whyme12/YUDX-tool-changer/Gcode/Klipper/Readme.txt

This is still work in progress, klipper macros will be here eventually
