whyme12/YUDX-tool-changer/BOM.xlsx

Sheet: BOM
 | Info: 1. The finished YUDX extruder kit may be released in the coming months. You may wait for its launch. 2. Amazon links were found by Claude Code. Links may be incorrect, please feedback any errors to me. 3. discord:https://discord.gg/vE4ExaVR3 4. https://github.com/dumplinglab/YUDX-tool-changer
number | Part group | Part Name (corresponds to STEP file) | Qty | Type | Details | Notes
1 | VORON existing part | MGN12H_block | 1 | Standard Part | MGN12H 300mm Premium Linear Guide Rail 2 Pcs MGN12 Linear Slide 8mm for 3D Printer CNC (2 Pcs/Pack)
2 | VORON existing part | MGN12 | 1 | Standard Part | MGN12H 300mm Premium Linear Guide Rail 2 Pcs MGN12 Linear Slide 8mm for 3D Printer CNC (2 Pcs/Pack)
3 | VORON existing part | Aluminum profiles | 1 | Standard Part
4 | Printer specific part | voron_connecting_part | 1 | 3D Printed Part |  | Add mounting option for EBB36?
5 | Printer specific part | M3x8mm ISO4762 | 4 | Standard Part | Screws to mount to MGN12 block
6 | Extruder | outer_shell_of_extruder | 1 | 3D Printed Part
7 | Extruder | double_layer_gear | 2 | Custom Gear
8 | Extruder | extrude_gear | 2 | Custom Gear
9 | Extruder | extrude_wheel | 2 | HGX-Lite | All included in a single HGX-Lite gear kit
10 | Extruder | needle_bearing | 2 | HGX-Lite | All included in a single HGX-Lite gear kit
11 | Extruder | one_way_bearing | 2 | Standard Part | HF0306
12 | Extruder | gear_container_metal_part | 2 | CNC
13 | Extruder | axle_for_extrude_gear | 2 | Custom part? | Diameter: 3mm, length: 24mm, 8mm ground flat on one side (1/4 D-Shaft) | change to D-shaft?
14 | Extruder | 0.5m10gear | 2 | Standard Part? | M0.5, 10 teeth, 3mm D-shaft | change to 12 teeth for more strength?
15 | Extruder | gear_container_plastic_part | 2 | 3D Printed Part
16 | Extruder | gear_container_metal_part_mirror | 2 | CNC
17 | Extruder | 4mm_flange_bearing | 6 | Standard Part | MF74ZZ flange bearing 4mmx7mmx2.5mm
18 | Extruder | 3mm_flange_bearing | 4 | Standard Part | MF63ZZ flange bearing 3mmx6mmx2.5mm
19 | Extruder | 4mm_axle | 2 | Standard Part | length 32mm
20 | Extruder | line_cut_rack | 1 | Custom Wire-cut Part | M0.5 gears require wire cutting
21 | Extruder | rack_below_part | 1 | CNC
22 | Extruder | extruder_bottom_metal_part | 1 | CNC
23 | Extruder | 36_stepper_motor | 1 | Standard part? | possibly fitting motor: Flashforge AD5X extruder motor
24 | Extruder | cylinder_pin1.5_5 | 6 | Standard Part | Diameter: 1.5mm, Length: 4mm
25 | Extruder | 4mm_flange_bearing_8mm | 2 | Standard Part | MF84ZZ flange bearing 4mmx8mmx3mm
26 | Extruder | extruder_top_metal_part_mirror | 1 | CNC
27 | Extruder | extruder_top_metal_part | 1 | CNC
28 | Extruder | throat_cooling_fan_seat | 1 | 3D Printed Part
29 | Extruder | 2510fan | 1 | Standard Part
30 | Extruder | model_cooling_fan_seat | 1 | 3D Printed Part
31 | Extruder | spring_0.8x7x30mm | 1 | Standard Part
32 | Extruder | 5020fan | 1 | Standard Part
33 | Extruder | bed_switch | 1 | Standard Part | for example: Omron D2F-01
34 | Extruder | M2x8mm ISO4762 | 2 | Standard Part | M2x8mm ISO4762
35 | Extruder | M3x10mm ISO7380-1 | 4 | Standard Part | Screws to mount model_cooling_fan_seat
36 | Extruder | front_cover | 1 | 3D Printed Part
37 | Extruder | M3x8mm ISO7380-1 | 2 | Standard Part | Screws to mount front_cover
38 | Extruder | back_cover | 1 | 3D Printed Part
39 | Extruder | M3x30mm ISO7380-1 | 8 | Standard Part | Screws to mount extruder_top_metal_part to extruder_bottom_metal_part
40 | Extruder | M3x8mm ISO10642 | 2 | Standard Part | Screws to mount stepper motor
41 | Extruder | M3x10mm ISO4762 | 4 | Standard Part | Screws to mount extruder_bottom_metal_part to voron_connecting_part
42 | Extruder | M3x8mm ISO10642 | 4 | Standard Part | Screws to mount gear_container_metal_part
43 | Extruder | M3x5mm ISO7380-1 | 2 | Standard Part | Screws to mount gear_container_plastic_part to gear_container_metal_part
44 | Extruder | M3x12mm ISO7380-1 | 2 | Standard Part | Screws for Spring
45 | Extruder | M3x14mm ISO7380-1 | 4 | Standard Part | Screws to mount 2510fan | Walls could be too thin around heat inserts, needs to be tested
46 | Extruder | M3x12mm ISO7380-1 | 3 | Standard Part | Screws to mount throat_cooling_fan_seat
47 | Extruder | A1104_hall_effect_sensor | 1 | Standard Part | (optional) Hall effect sensor A1104LUA-T (not SMD variant) to detect tool change fails
48 | Extruder & Toolhead | magnet_5-15-3 | 4 + N*4 | Standard Part |  | Pocket size in Step maybe to small? Only 14.5x4.5mm
49 | Toolhead | Tool_head_front_part | N | 3D Printed Part |  | Pocket size in Step maybe to small? Only 14.5x4.5mm
50 | Toolhead | Bambu_Hotend | N | Standard Part |  | Create second Tool_head_front_part to support Snapmaker U1 hotends
51 | Toolhead | 4mm_ball | N*4 | Standard Part | 4mm ball bearing ball
52 | Toolhead | Tool_head_back_part | N | 3D Printed Part |  | Do the latches work when 3d printed and not break off?
53 | Toolhead | square_nut | N*2 | Standard Part
54 | Toolhead | M3x14mm ISO4762 | N*2 | Standard Part | Screws to mount Bambu_Hotend
55 | Toolhead | M3x6mm ISO7380-1 | N*4 | Standard Part | Screws to mount Tool_head_back_part to Tool_head_front_part
56 | Toolhead | Magnet_4x2mm | N | Standard Part | Diameter 4mm, height 2mm | To be able to detect toolchange success using hall effect sensor
57 | Dock | tool_head_seat | N | 3D Printed Part |  | Maybe add additional screws from front?
58 | Dock | mini_door_lock_switch | N*2 | Standard Part
59 | Dock | nozzle_cleaning_part | N | 3D Printed Part
60 | Dock | 3010fan | N | Standard Part
61 | Dock | air_guide | N | 3D Printed Part
62 | Dock | 4.5mm_silicon_sleeve | N | ??? |  | where to get this part from?
63 | Dock | M3x12mm ISO4762 | N*4 | Standard Part | Screws to mount nozzle_cleaning_part
64 | Dock | M3x20mm ISO4762 | N*4 | Standard Part | Screws to mount 3010fan and air_guide
65 | Dock | M3x8mm ISO4762 | N*2 | Standard Part | Screws to mount tool_head_seat to aluminium extrusion
66 | Dock | T-nut | N*2 | Standard Part | T-nut to mount tool_head_seat to aluminium extrusion
67 | Overall | Heat set inserts | 31+N*8 | Standard Part | Heat set inserts M3x5x4mm (Voron style)

Sheet: Screw types
Type | Quantity
M3x8mm ISO4762 | 4+N*2
M3x10mm ISO4762 | 4
M3x12mm ISO4762 | N*4
M3x14mm ISO4762 | N*2
M3x20mm ISO4762 | N*4
M3x8mm ISO10642 | 6
M3x5mm ISO7380-1 | 2
M3x6mm ISO7380-1 | N*4
M3x8mm ISO7380-1 | 2
M3x10mm ISO7380-1 | 4
M3x12mm ISO7380-1 | 5
M3x14mm ISO7380-1 | 4
M3x30mm ISO7380-1 | 8
