whyme12/YUDX-tool-changer/CAD/YUDX assemble.STEP

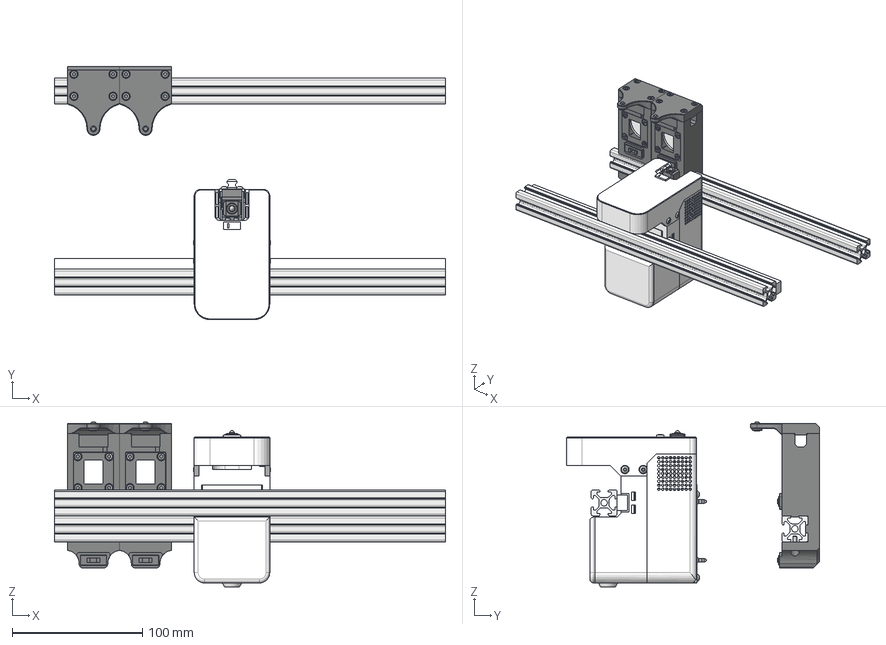
[picture p1: CAD file, 2026-09-14]
CAD/YUDX assemble.STEP
300.0 x 194.4 x 126.4 mm
M3_heat_insert x 47
throat_cooling_fan_seat
2510fan
model_cooling_fan_seat
5020fan
bed_switch
back_cover
tool_head_seat x 2
mini_door_lock_switch x 4
nozzle_cleaning_part x 2
3010fan x 2
air_guide x 2
4.5mm_silicon_sleeve x 2
ISO 4762 - M3 x 12 Steel 8.8 Plain x 8
ISO 4762 - M3 x 8 Steel 4.6 Plain x 4
ISO 4762 - M3 x 20 Steel 8.8 Plain x 8
ISO 7380-1 - M3 x 10 Steel 4.6 Plain x 4
outer_shell_of_extruder
double_layer_gear
extrude_gear
extrude_wheel
needle_bearing
one_way_bearing
gear_container_metal_part
axle_for_extrude_gear
0.5m10gear
gear_container_plastic_part
gear_container_metal_part_mirror
4mm_flange_bearing x 4
3mm_flange_bearing x 2
4mm_axle
line_cut_rack
rack_below_part
extruder_bottom_metal_part
36_stepper_motor
4mm_flange_bearing_8mm x 2
cylinder_pin1.5_5 x 6
magnet_5-15-3 x 4
镜向double_layer_gear
镜向extrude_gear
镜向extrude_wheel
镜向needle_bearing
镜向one_way_bearing
镜向gear_container_metal_part
镜向axle_for_extrude_gear
镜向0.5m10gear
镜向gear_container_plastic_part
镜向gear_container_metal_part_mirror
镜向4mm_flange_bearing x 2
镜向3mm_flange_bearing x 2
镜向4mm_axle
ISO 7380-1 - M3 x 30 Steel 8.8 Black x 8
DIN EN ISO 10642 - M3 x 8 Steel 8.8 Plain x 2
DIN 7991 - M3x8 Steel 10.9 Plain x 4
ISO 7380-2 - M3 x 12 Steel 4.6 Plain x 2
ISO 7380-1 - M3 x 6 Steel 4.6 Plain x 6
A1104_hall_effect_sensor
spring_0.8x7x30mm
Tool_head_front_part
Bambu_Hotend1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
