whyme12/YUDX-tool-changer/CAD/YUDX Extruder.STEP

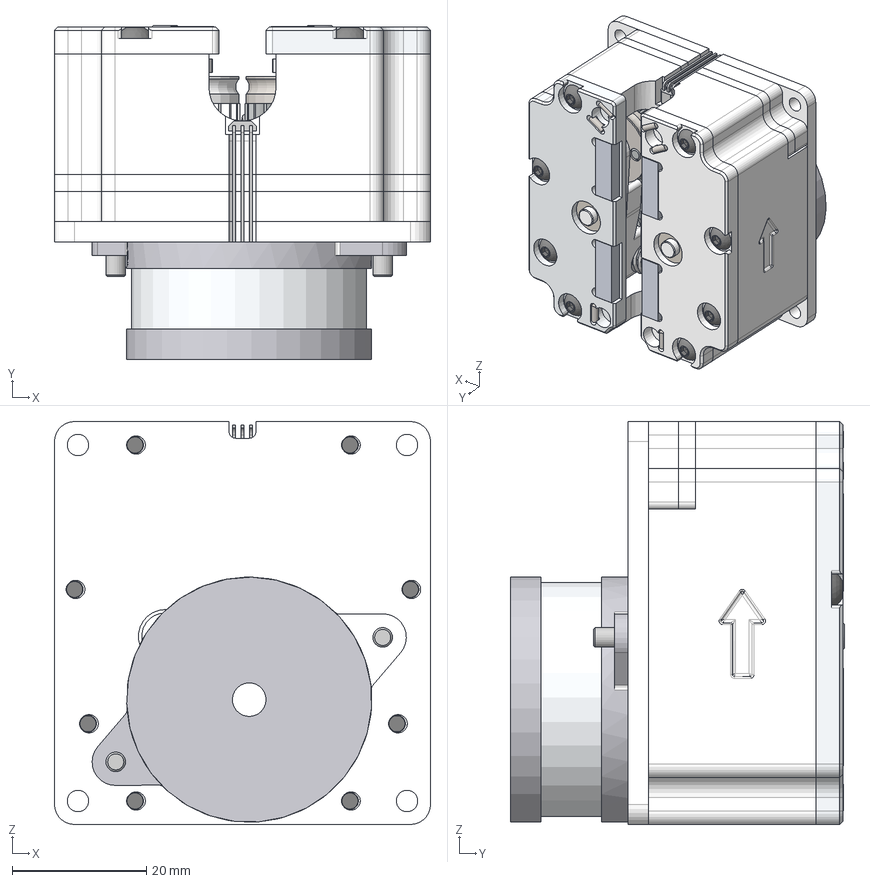
[picture p2: CAD file, 2026-09-14]
CAD/YUDX Extruder.STEP
56.0 x 49.7 x 60.0 mm
outer_shell_of_extruder
double_layer_gear
extrude_gear
extrude_wheel
needle_bearing
one_way_bearing
gear_container_metal_part
axle_for_extrude_gear
0.5m10gear
gear_container_plastic_part
gear_container_metal_part_mirror
4mm_flange_bearing x 4
3mm_flange_bearing x 2
4mm_axle
M3_heat_insert x 6
line_cut_rack
rack_below_part
extruder_bottom_metal_part
36_stepper_motor
4mm_flange_bearing_8mm x 2
cylinder_pin1.5_5 x 6
magnet_5-15-3 x 4
镜向double_layer_gear
镜向extrude_gear
镜向extrude_wheel
镜向needle_bearing
镜向one_way_bearing
镜向gear_container_metal_part
镜向axle_for_extrude_gear
镜向0.5m10gear
镜向gear_container_plastic_part
镜向gear_container_metal_part_mirror
镜向4mm_flange_bearing x 2
镜向3mm_flange_bearing x 2
镜向4mm_axle
ISO 7380-1 - M3 x 30 Steel 8.8 Black x 8
DIN EN ISO 10642 - M3 x 8 Steel 8.8 Plain x 2
DIN 7991 - M3x8 Steel 10.9 Plain x 4
ISO 7380-2 - M3 x 12 Steel 4.6 Plain x 2
ISO 7380-1 - M3 x 6 Steel 4.6 Plain x 2
A1104_hall_effect_sensor
spring_0.8x7x30mm
