whyme12/YUDX-tool-changer/CNC Parts/2x_gear_container_metal_part.step

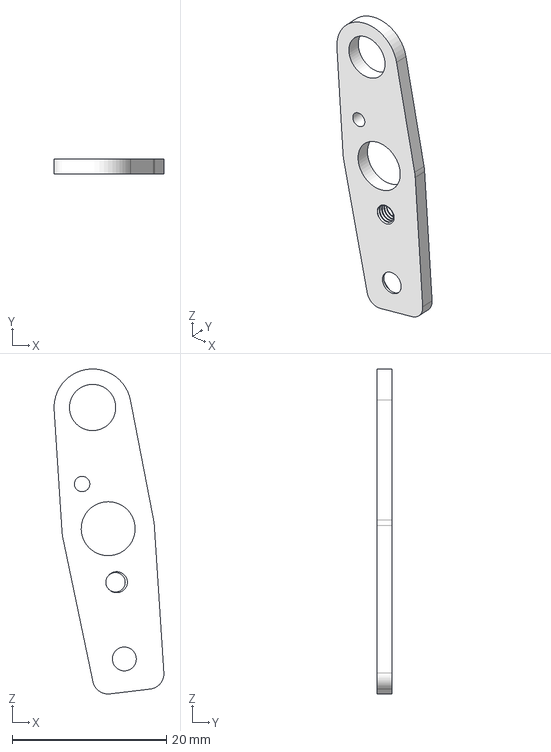
[picture p3: CAD file, 2026-09-12]
CNC Parts/2x_gear_container_metal_part.step
14.2 x 2.00 x 42.2 mm
