whyme12/YUDX-tool-changer/STLs/Dock/nozzle_cleaning_part.stl

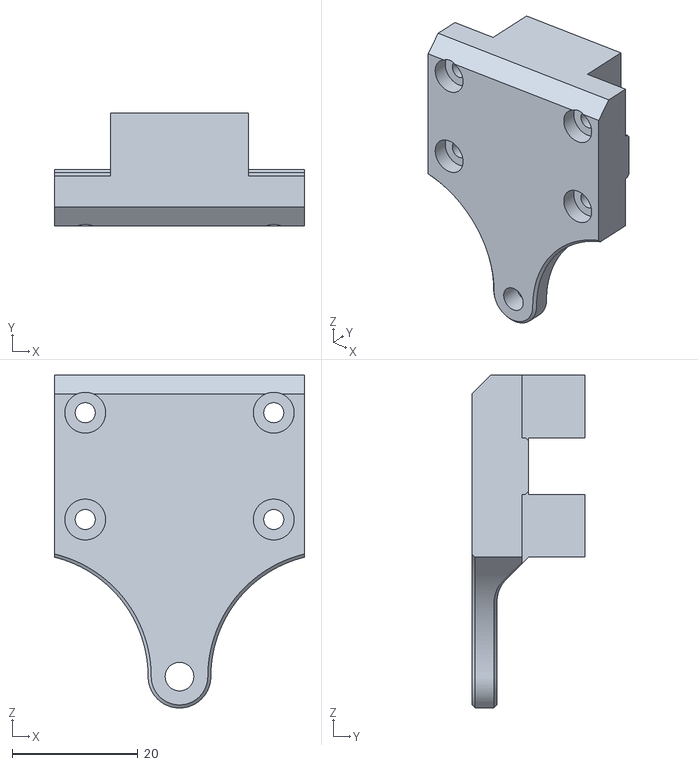
[picture p4: CAD file, 2026-09-12]
STLs/Dock/nozzle_cleaning_part.stl
39.8 x 18.0 x 53.0
