whyme12/YUDX-tool-changer/STLs/Extruder/gear_container_plastic_part.stl

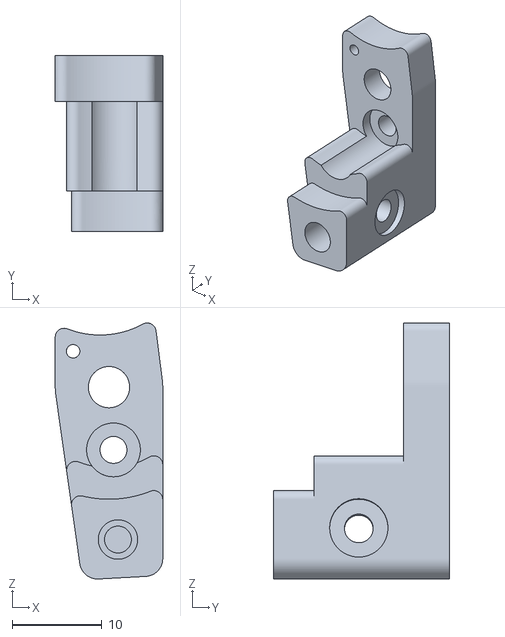
[picture p5: CAD file, 2026-09-12]
STLs/Extruder/gear_container_plastic_part.stl
12.0 x 19.6 x 28.6
