whyme12/YUDX-tool-changer/STLs/Printer specific/Voron2.4 MGN12/throat_cooling_fan_seat.stl

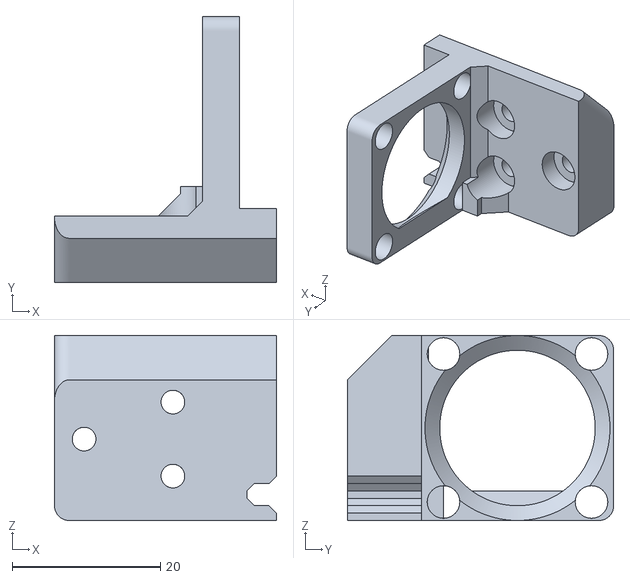
[picture p6: CAD file, 2026-09-12]
STLs/Printer specific/Voron2.4 MGN12/throat_cooling_fan_seat.stl
30.0 x 36.0 x 25.0
