whyme12/YUDX-tool-changer/STLs/Toolhead/Tool_head_front_part.stl

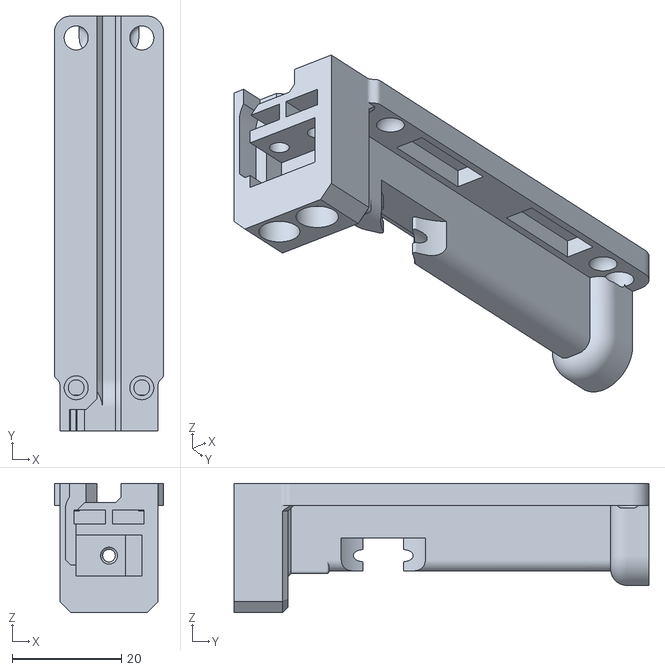
[picture p7: CAD file, 2026-09-14]
STLs/Toolhead/Tool_head_front_part.stl
20.0 x 75.9 x 23.6
