whyme12/YUDX-tool-changer/CNC Parts/line_cut_rack.step

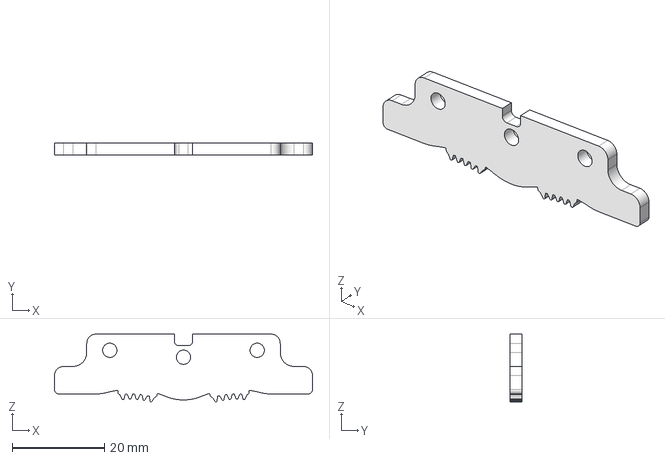
[picture p8: CAD file, 2026-09-12]
CNC Parts/line_cut_rack.step
56.0 x 2.50 x 14.7 mm
