whyme12/YUDX-tool-changer/STLs/Dock/air_guide.stl

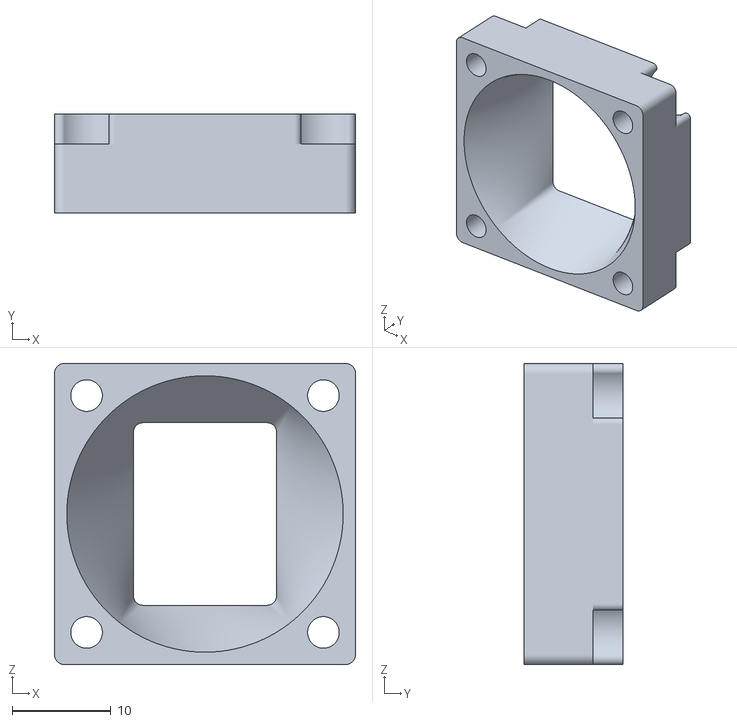
[picture p9: CAD file, 2026-09-12]
STLs/Dock/air_guide.stl
30.5 x 10.0 x 30.5
