whyme12/YUDX-tool-changer/STLs/Printer specific/Voron2.4 MGN12/voron_connecting_part.stl

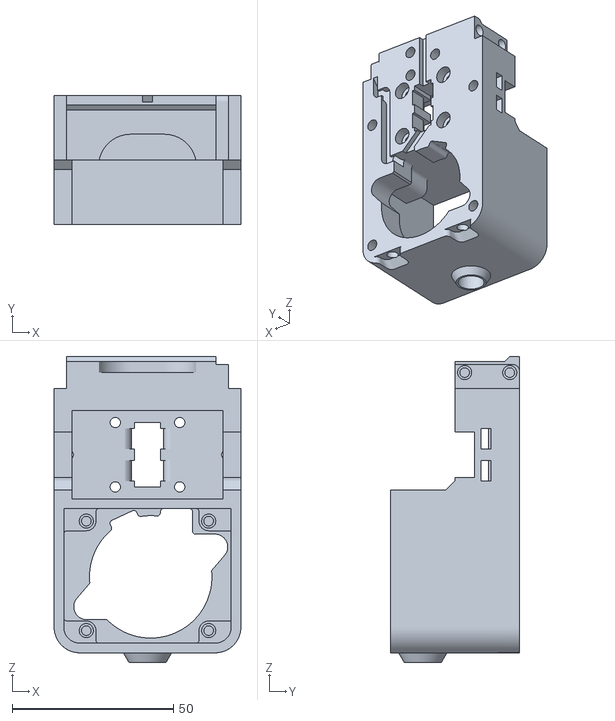
[picture p10: CAD file, 2026-09-12]
STLs/Printer specific/Voron2.4 MGN12/voron_connecting_part.stl
58.0 x 40.0 x 95.0
