whyme12/YUDX-tool-changer/STLs/Toolhead/Tool_head_back_part.stl

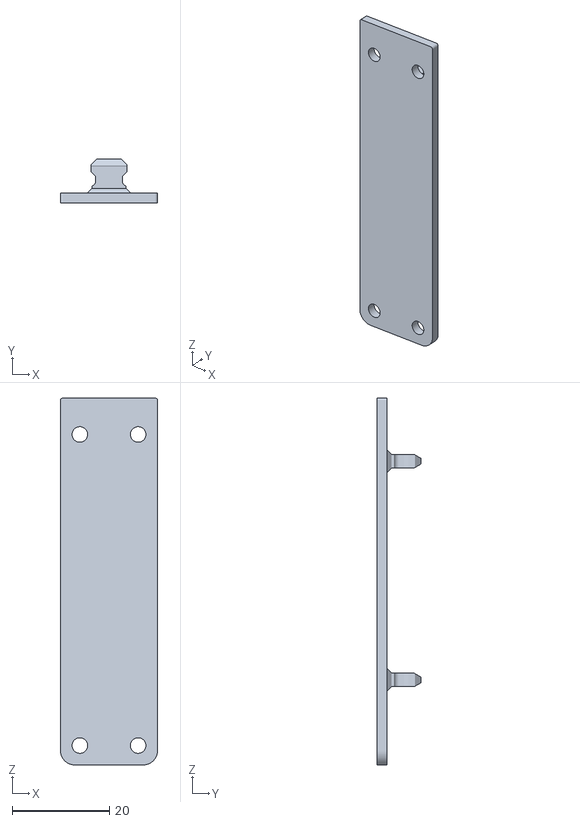
[picture p11: CAD file, 2026-09-12]
STLs/Toolhead/Tool_head_back_part.stl
20.0 x 9.00 x 75.5
