whyme12/YUDX-tool-changer/CNC Parts/extruder_top_metal_part_mirror.step

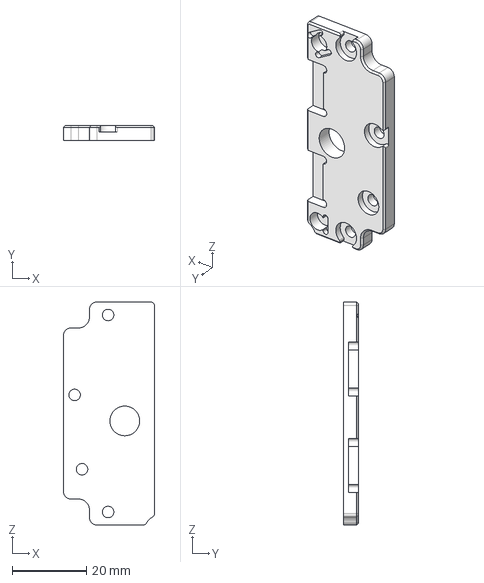
[picture p13: CAD file, 2026-09-12]
CNC Parts/extruder_top_metal_part_mirror.step
24.5 x 4.00 x 60.0 mm
