whyme12/YUDX-tool-changer/STLs/Dock/tool_head_seat.stl

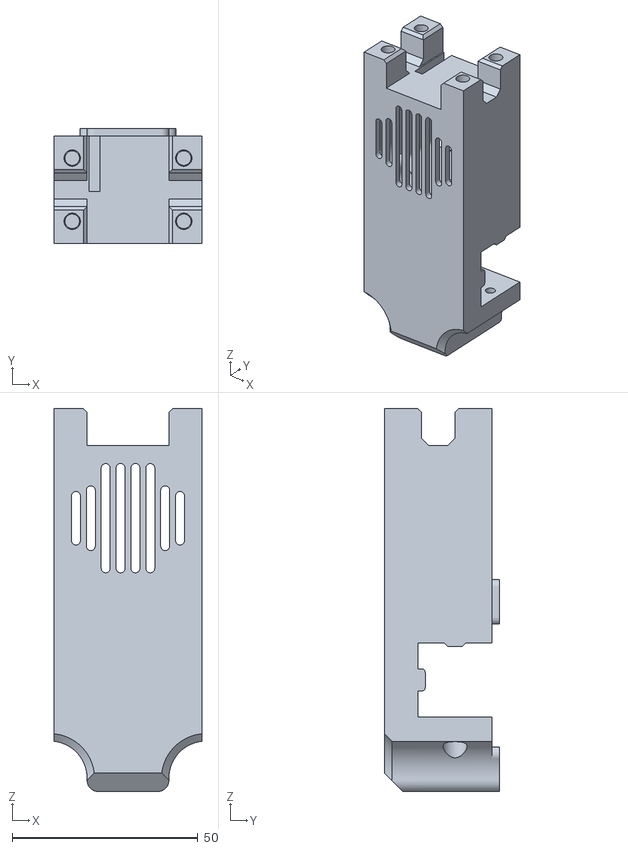
[picture p14: CAD file, 2026-09-12]
STLs/Dock/tool_head_seat.stl
39.8 x 31.0 x 103.0
