whyme12/YUDX-tool-changer/STLs/Extruder/outer_shell_of_extruder.stl

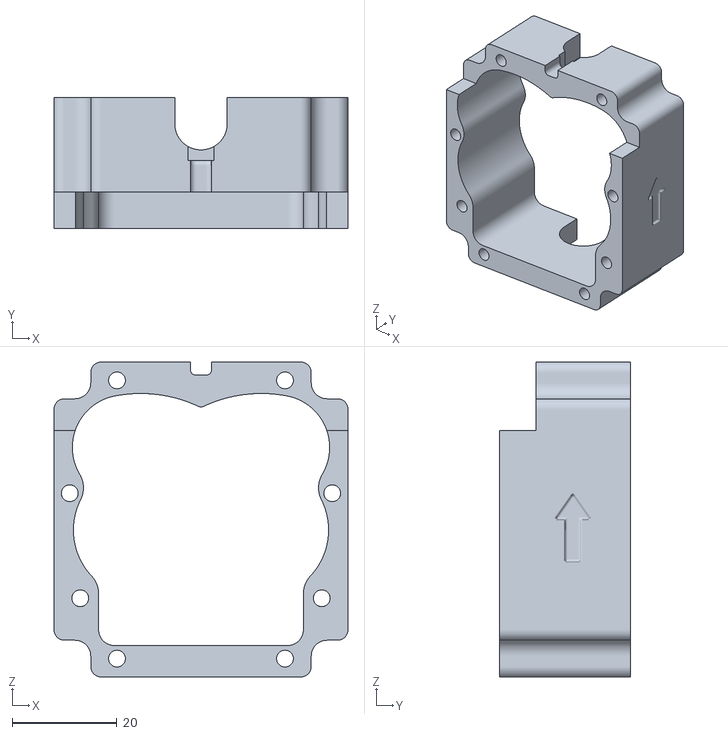
[picture p15: CAD file, 2026-09-12]
STLs/Extruder/outer_shell_of_extruder.stl
56.0 x 25.0 x 60.0
