whyme12/YUDX-tool-changer/STLs/Printer specific/Voron2.4 MGN12/back_cover.stl

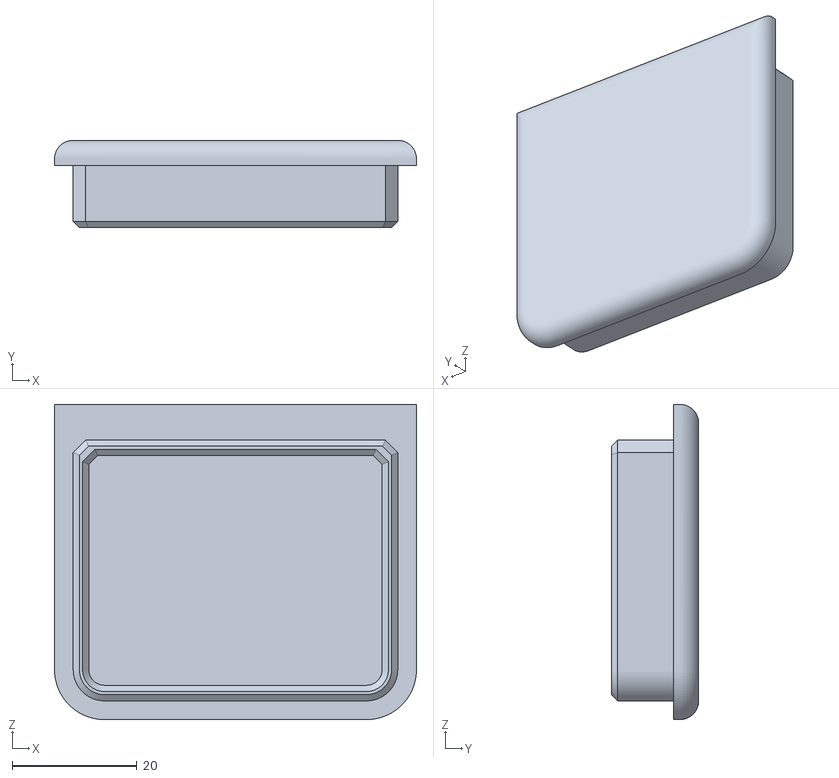
[picture p16: CAD file, 2026-09-12]
STLs/Printer specific/Voron2.4 MGN12/back_cover.stl
58.0 x 14.0 x 50.5
