whyme12/YUDX-tool-changer/CAD/YUDX_toolhead_seat.step

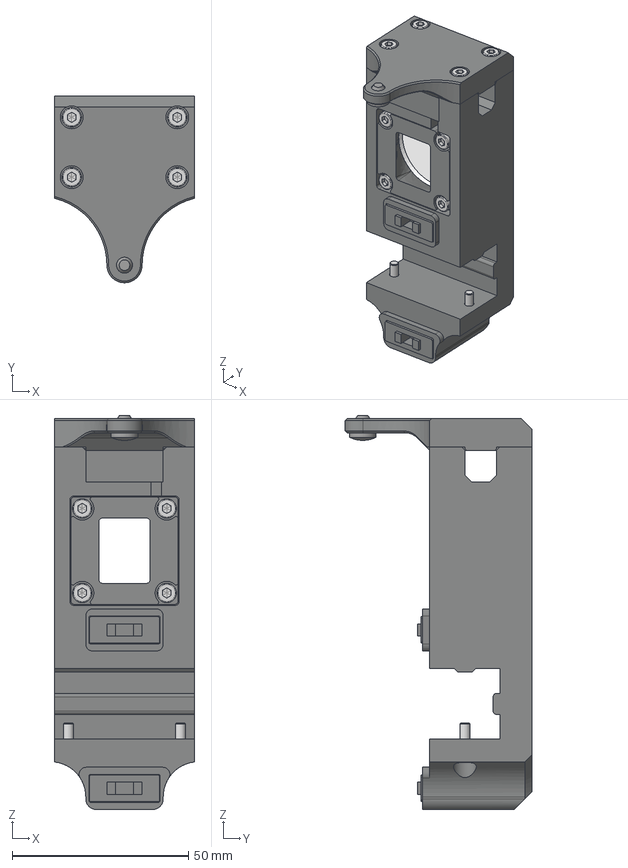
[picture p17: CAD file, 2026-09-12]
CAD/YUDX_toolhead_seat.step
39.8 x 53.0 x 111.9 mm
tool_head_seat
mini_door_lock_switch x 2
nozzle_cleaning_part
3010fan
air_guide
4.5mm_silicon_sleeve
M3_heat_insert x 8
ISO 4762 - M3 x 12 Steel 8.8 Plain x 4
ISO 4762 - M3 x 8 Steel 4.6 Plain x 2
ISO 4762 - M3 x 20 Steel 8.8 Plain x 4
