whyme12/YUDX-tool-changer/STLs/Printer specific/Voron2.4 MGN12/front_cover.stl

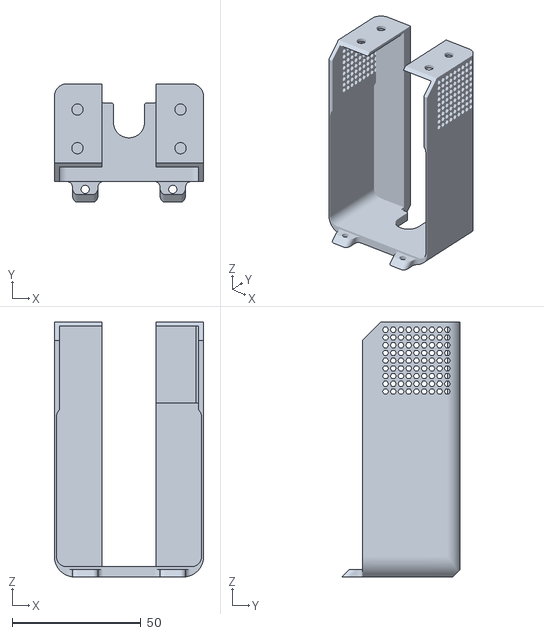
[picture p18: CAD file, 2026-09-12]
STLs/Printer specific/Voron2.4 MGN12/front_cover.stl
58.0 x 46.0 x 99.0
