whyme12/YUDX-tool-changer/CNC Parts/2x_double_layer_gear.step

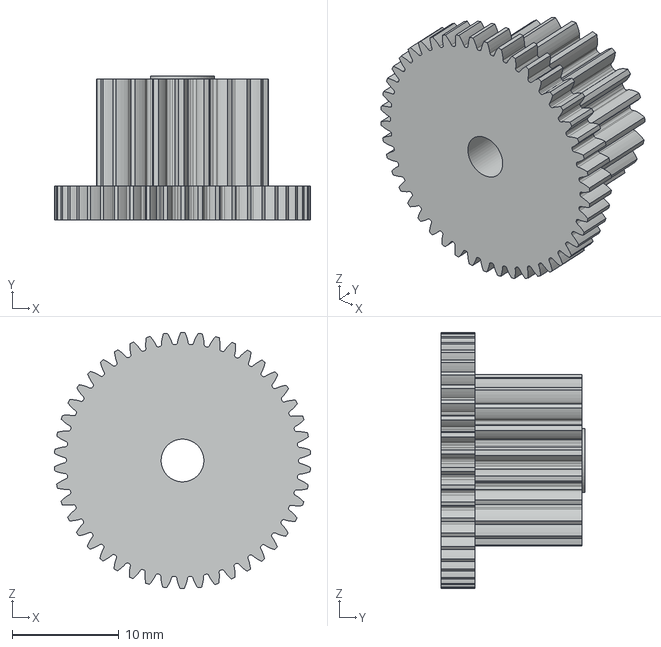
[picture p19: CAD file, 2026-09-12]
CNC Parts/2x_double_layer_gear.step
24.0 x 13.5 x 24.0 mm
