whyme12/YUDX-tool-changer/STLs/Printer specific/Voron2.4 MGN12/model_cooling_fan_seat.stl

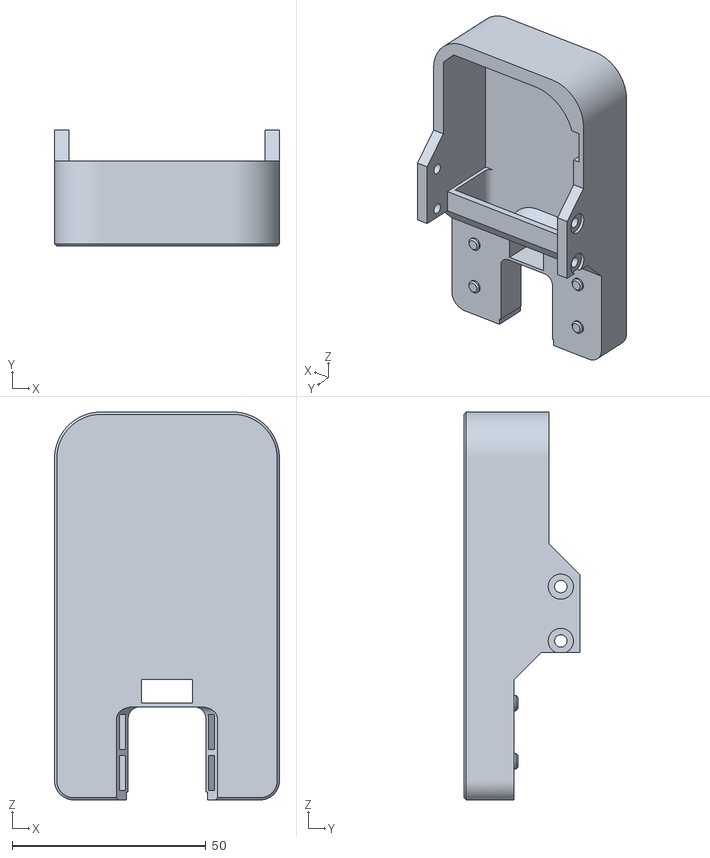
[picture p20: CAD file, 2026-09-12]
STLs/Printer specific/Voron2.4 MGN12/model_cooling_fan_seat.stl
58.0 x 30.0 x 100.0
