whyme12/YUDX-tool-changer/CNC Parts/extruder_bottom_metal_part.step

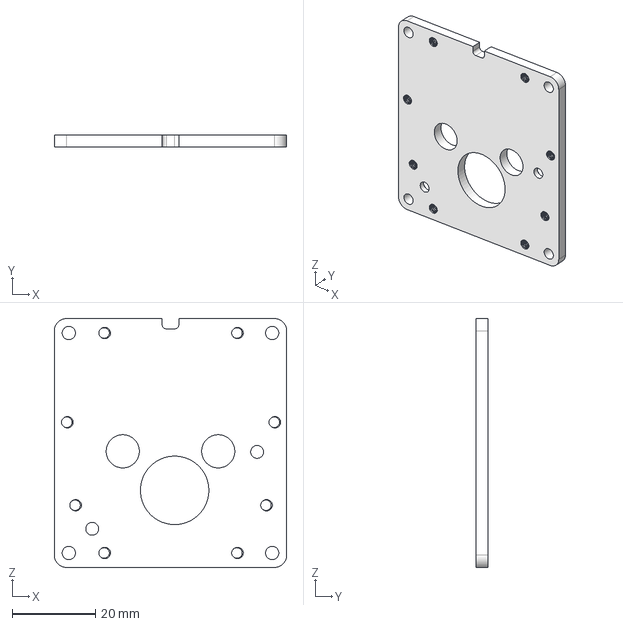
[picture p21: CAD file, 2026-09-12]
CNC Parts/extruder_bottom_metal_part.step
56.0 x 3.00 x 60.0 mm
