whyme12/YUDX-tool-changer/CNC Parts/rack_below_part.step

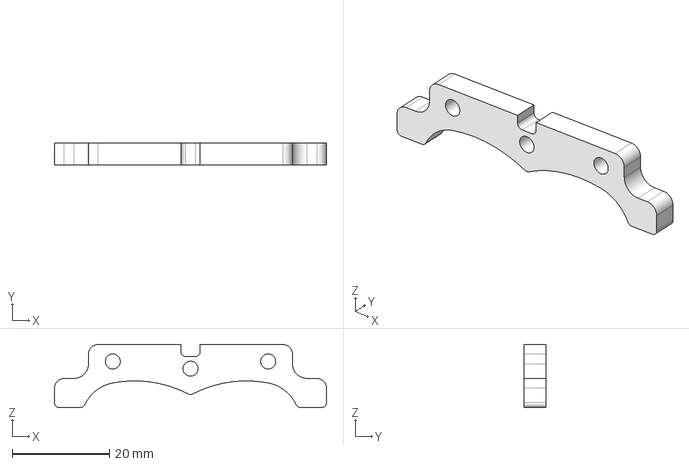
[picture p22: CAD file, 2026-09-12]
CNC Parts/rack_below_part.step
56.0 x 4.50 x 13.0 mm
