whyme12/YUDX-tool-changer/CNC Parts/2x_extrude_gear.step

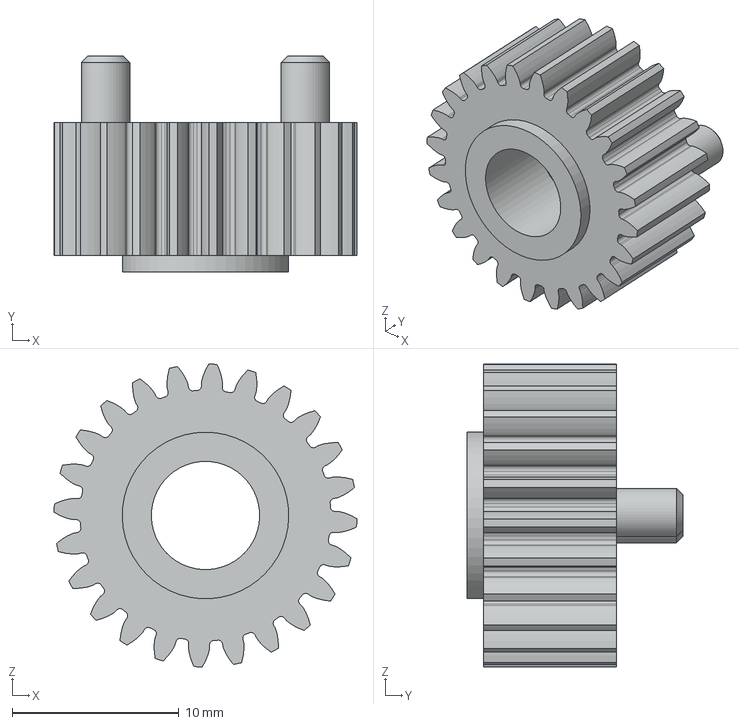
[picture p23: CAD file, 2026-09-12]
CNC Parts/2x_extrude_gear.step
18.2 x 13.0 x 18.2 mm
