whyme12/YUDX-tool-changer/(list of files, cad)

Other CAD files:
STLs/Extruder/gear_container_plastic_part_mirrored.stl
CNC Parts/extruder_top_metal_part.step
CNC Parts/2x_gear_container_metal_part_mirror.step
