whyme12/YUDX-tool-changer/(commit log)

2026-09-12 Updated Step files and renamed directory from '3dmodel' to 'CAD'
    [Tool_head_assumption.STEP, YUDX Extruder.STEP, YUDX assemble.STEP, YUDX_toolhead_seat.step]
2026-09-12 Reorganized 'Gcode' directory for different printer firmwares
    [disoffest.g, offest.g, tfree0.g, tpost0.g]
2026-09-12 Reorganized 'STLs' directory
    [Tool_head_back_part.STL, Tool_head_back_part.stl, Tool_head_front_part.stl, Tool_head_front_part2.STL, air_guide.STL, air_guide.stl, back_cover.STL, back_cover.stl]
2026-09-12 Added 'CNC Parts' directory for all the custom metal parts
    [2x_double_layer_gear.step, 2x_extrude_gear.step, 2x_gear_container_metal_part.step, 2x_gear_container_metal_part_mirror.step, extruder_bottom_metal_part.step, extruder_top_metal_part.step, extruder_top_metal_part_mirror.step, line_cut_rack.step]
2026-09-14 Small fixes
    [BOM.xlsx, Tool_head_assumption.STEP, Tool_head_front_part.stl, YUDX Extruder.STEP, YUDX assemble.STEP]
